kenji-liu/evo2-mount-sim/(list of files, cad)

Other CAD files:
v7-evo_front_adh.skp
v7-qr_assembly.skp
v7-qr_base.skp
v7-qr_ring.skp
