kenji-liu/evo2-mount-sim/(commit log)

2026-10-05 EVO II Pro V3 鏡組掛載模擬網頁
2026-10-05 加入 ALIGN 亞拓 M3 RTK 機型；V4 改名為鏡組快拆支架
2026-10-06 加入機頭夾持支架、機腹支架 B1/B2 與腳架延長件；校正 EVO II 機身高度
2026-10-06 Move nose lens mount in front of EVO II and ALIGN M3 RTK
2026-10-06 新增兩機型前置夾持／黏貼與 ALIGN 機腹 B1、B2 試裝模型及 STEP/STL 下載
2026-10-08 EVO V7：放寬鏡筒及肩圈配合、加厚支架與擴大黏貼面，新增原生 SKP 和尺寸圖下載
    [v7-evo_front_adh.skp, v7-qr_assembly.skp, v7-qr_base.skp, v7-qr_ring.skp]
